TheCl3m/PortableArcade/README.md

### This is the official page of the Portable Arcade project for the course CS-358 @EPFL
