TheCl3m/PortableArcade/docs/assets/gant3d.png

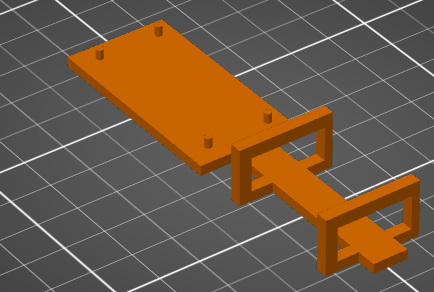
docs/assets/gant3d.png
