TheCl3m/PortableArcade/docs/assets/joy.gif

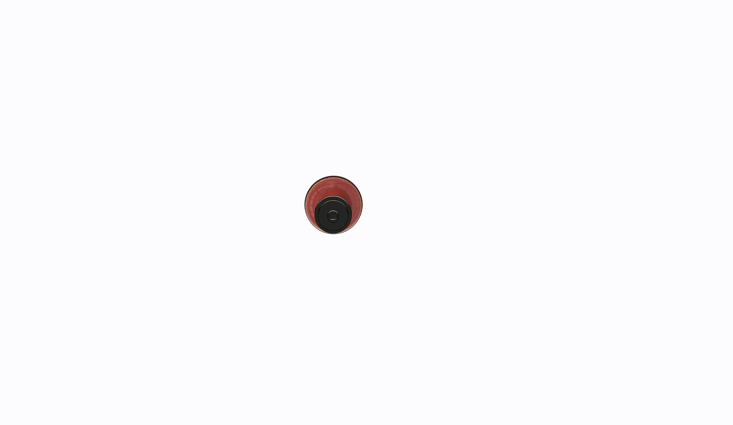
docs/assets/joy.gif
