TheCl3m/PortableArcade/docs/assets/lever.gif

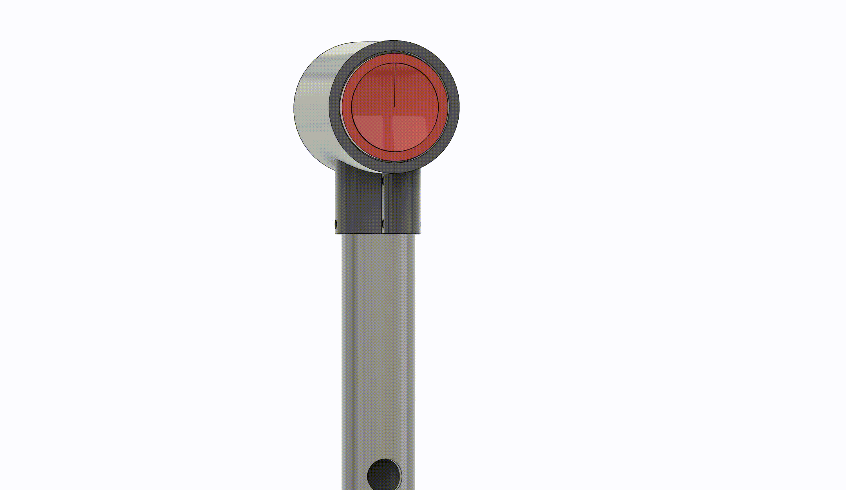
docs/assets/lever.gif
