TheCl3m/PortableArcade/3D-Printing/JoystickAndButtons/Joysticks and Buttons/Joystick head.stl

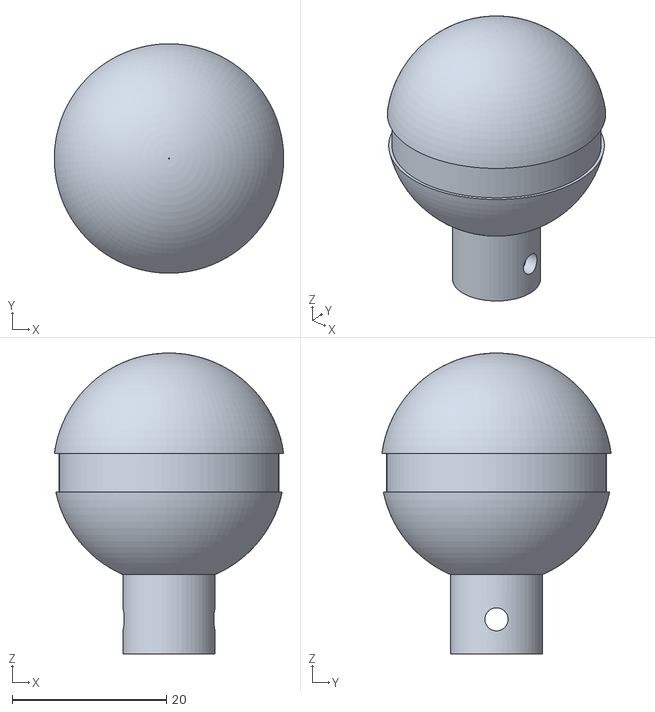
[picture p9: CAD file, 2022-06-02]
3D-Printing/JoystickAndButtons/Joysticks and Buttons/Joystick head.stl
29.8 x 29.8 x 39.1
