TheCl3m/PortableArcade/3D-Printing/SteeringWheel/Steering wheel and gear lever/Gear Lever/Lever head right.stl

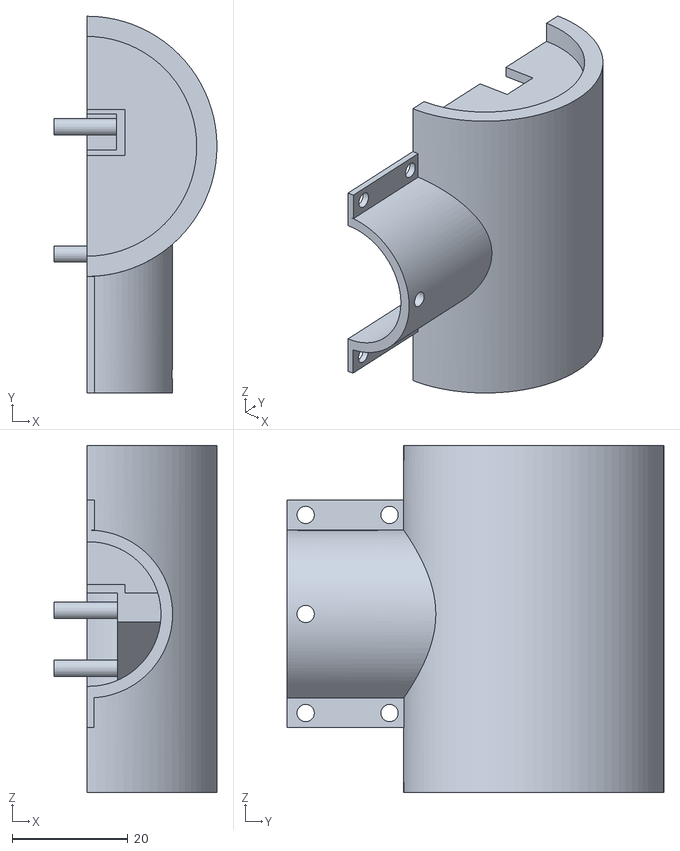
[picture p10: CAD file, 2022-06-02]
3D-Printing/SteeringWheel/Steering wheel and gear lever/Gear Lever/Lever head right.stl
28.2 x 65.1 x 60.0
