TheCl3m/PortableArcade/3D-Printing/SteeringWheel/Steering wheel and gear lever/Wheel/Grip Bottom.stl

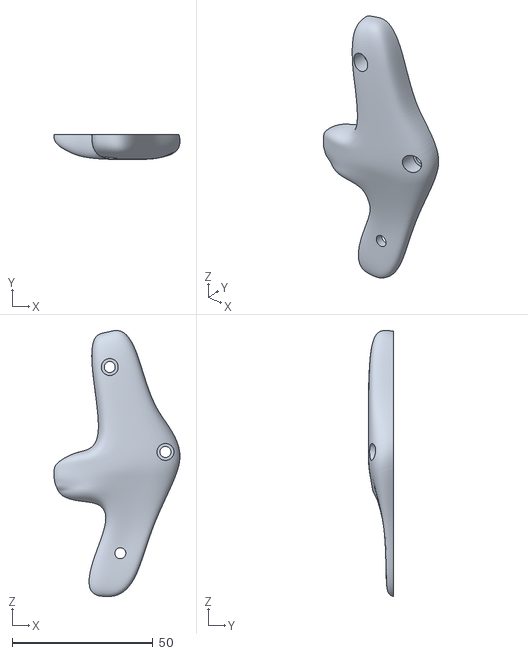
[picture p11: CAD file, 2022-06-02]
3D-Printing/SteeringWheel/Steering wheel and gear lever/Wheel/Grip Bottom.stl
44.8 x 9.02 x 94.5
