TheCl3m/PortableArcade/3D-Printing/JoystickAndButtons/Joysticks and Buttons/Circle base final.stl

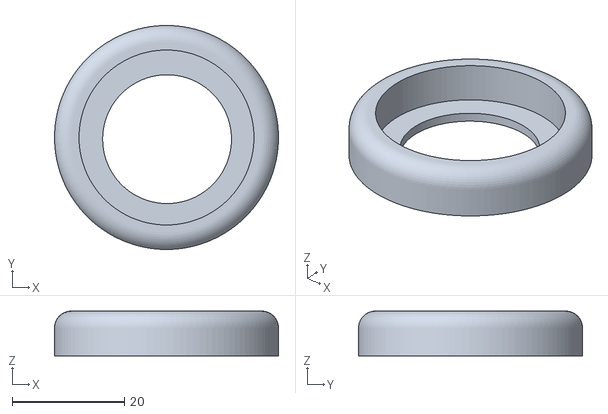
[picture p12: CAD file, 2022-06-02]
3D-Printing/JoystickAndButtons/Joysticks and Buttons/Circle base final.stl
40.0 x 40.0 x 8.00
