TheCl3m/PortableArcade/3D-Printing/SteeringWheel/Steering wheel and gear lever/Gear Lever/Lever.stl

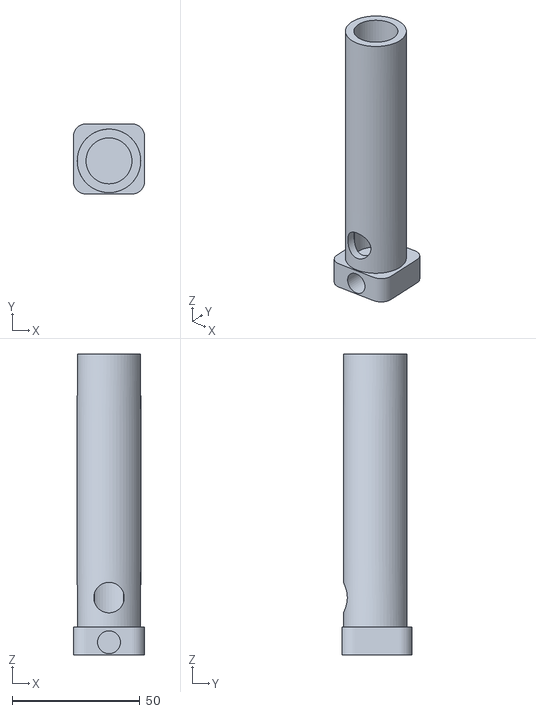
[picture p13: CAD file, 2022-06-02]
3D-Printing/SteeringWheel/Steering wheel and gear lever/Gear Lever/Lever.stl
28.0 x 27.5 x 118.0
