TheCl3m/PortableArcade/3D-Printing/SteeringWheel/Steering wheel and gear lever/Wheel/Potentiometer holder.stl

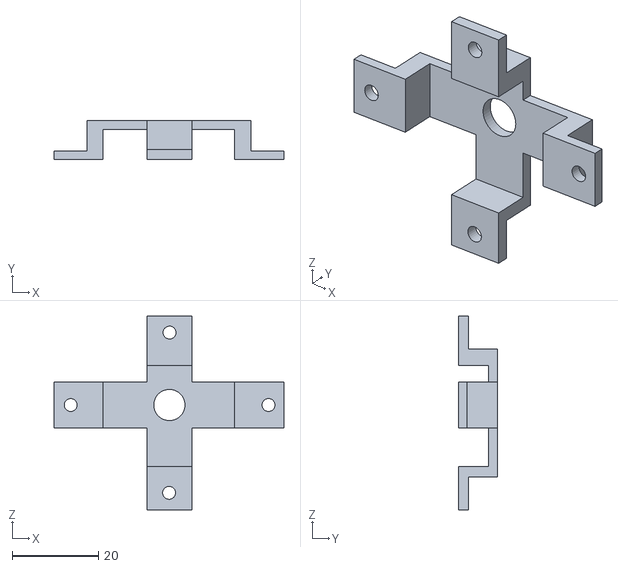
[picture p14: CAD file, 2022-06-02]
3D-Printing/SteeringWheel/Steering wheel and gear lever/Wheel/Potentiometer holder.stl
53.3 x 8.97 x 45.0
