TheCl3m/PortableArcade/3D-Printing/JoystickAndButtons/Joysticks and Buttons/Microswitch module.stl

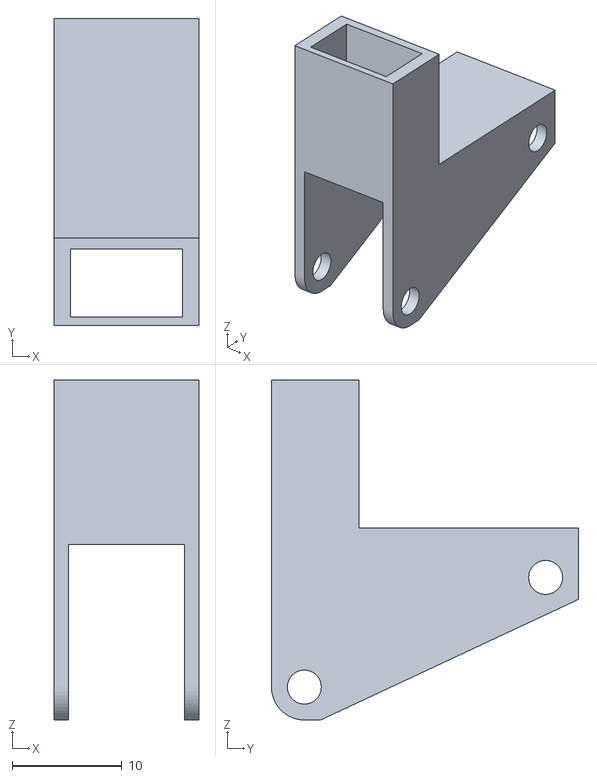
[picture p15: CAD file, 2022-06-02]
3D-Printing/JoystickAndButtons/Joysticks and Buttons/Microswitch module.stl
13.2 x 28.0 x 31.0
