TheCl3m/PortableArcade/3D-Printing/SteeringWheel/Steering wheel and gear lever/Gear Lever/Solid stick.stl

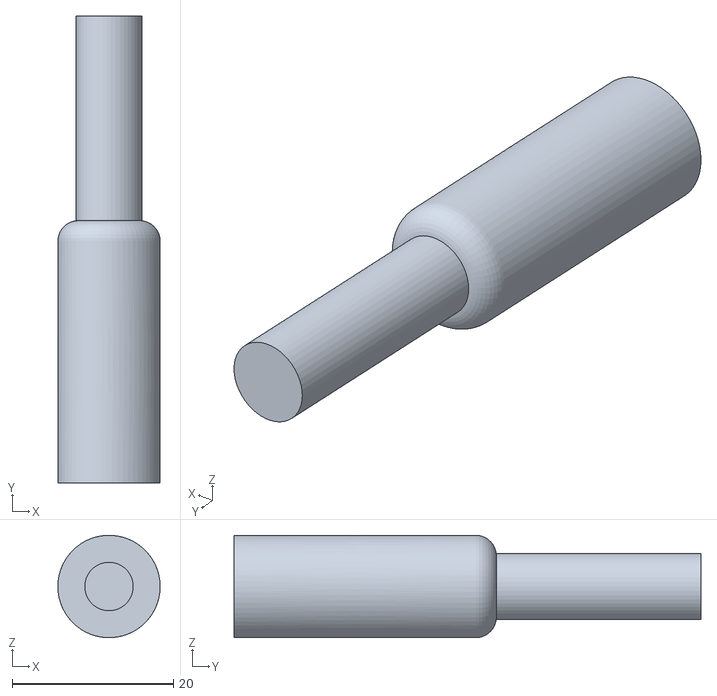
[picture p16: CAD file, 2022-06-02]
3D-Printing/SteeringWheel/Steering wheel and gear lever/Gear Lever/Solid stick.stl
12.7 x 57.9 x 12.7
