TheCl3m/PortableArcade/3D-Printing/SteeringWheel/Steering wheel and gear lever/Wheel/Grip Top.stl

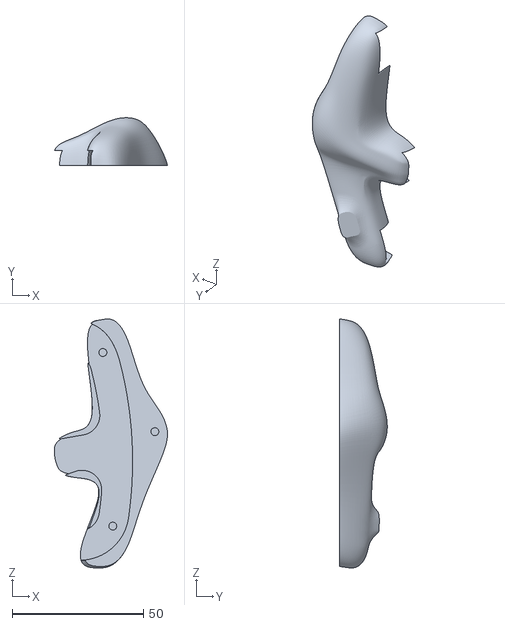
[picture p17: CAD file, 2022-06-02]
3D-Printing/SteeringWheel/Steering wheel and gear lever/Wheel/Grip Top.stl
43.1 x 18.1 x 94.9
