TheCl3m/PortableArcade/3D-Printing/JoystickAndButtons/Joysticks and Buttons/Joystick stick.stl

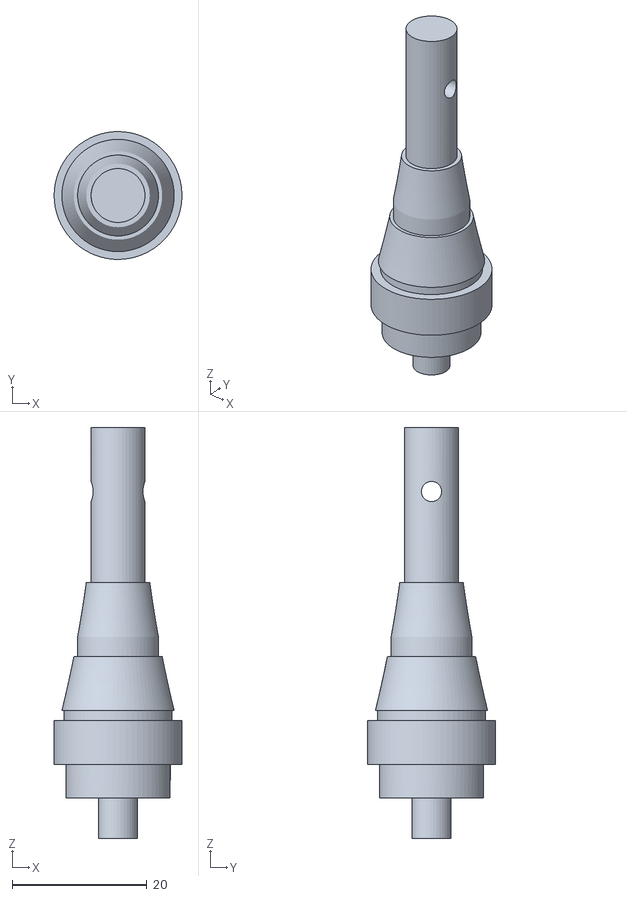
[picture p18: CAD file, 2022-06-02]
3D-Printing/JoystickAndButtons/Joysticks and Buttons/Joystick stick.stl
19.0 x 19.0 x 61.0
