TheCl3m/PortableArcade/3D-Printing/SteeringWheel/Steering wheel and gear lever/Gear Lever/Weights.stl

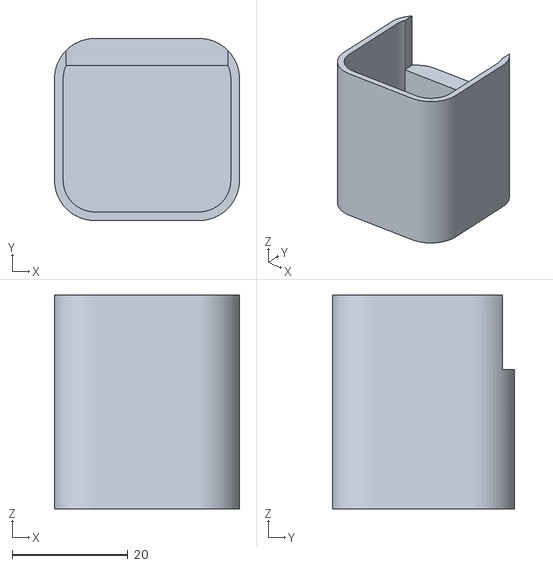
[picture p19: CAD file, 2022-06-02]
3D-Printing/SteeringWheel/Steering wheel and gear lever/Gear Lever/Weights.stl
32.0 x 31.5 x 37.0
