TheCl3m/PortableArcade/3D-Printing/SteeringWheel/Steering wheel and gear lever/Gear Lever/Lever presser.stl

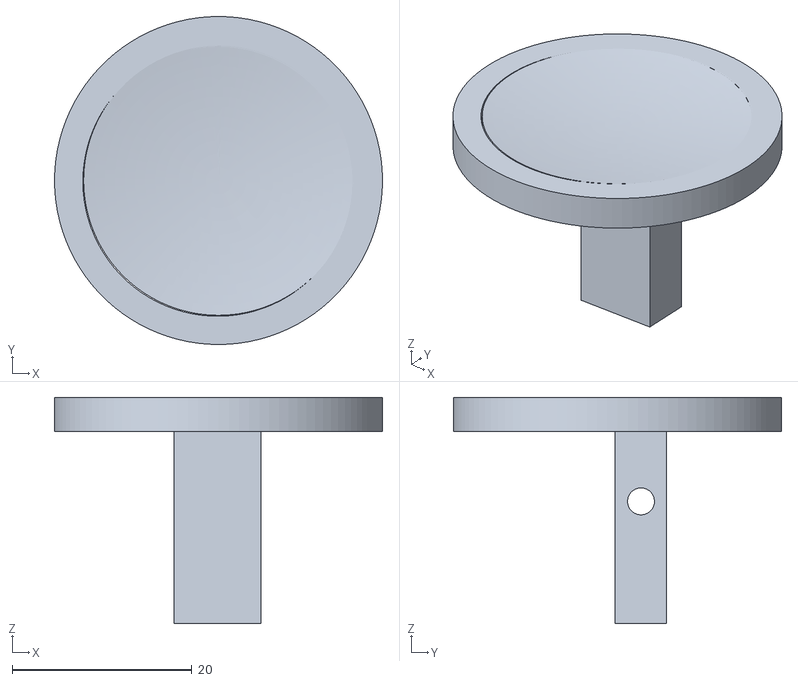
[picture p20: CAD file, 2022-06-02]
3D-Printing/SteeringWheel/Steering wheel and gear lever/Gear Lever/Lever presser.stl
36.5 x 36.5 x 25.2
