TheCl3m/PortableArcade/3D-Printing/SteeringWheel/Steering wheel and gear lever/Wheel/Wooden box module.stl

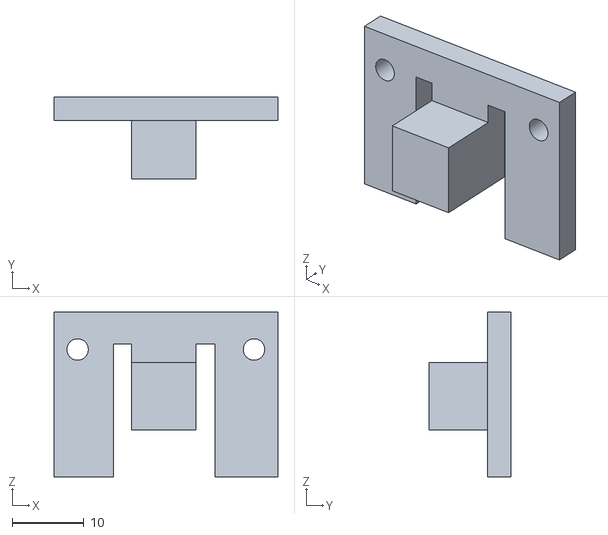
[picture p21: CAD file, 2022-06-02]
3D-Printing/SteeringWheel/Steering wheel and gear lever/Wheel/Wooden box module.stl
31.3 x 11.4 x 23.0
