TheCl3m/PortableArcade/3D-Printing/JoystickAndButtons/Joysticks and Buttons/Box top.stl

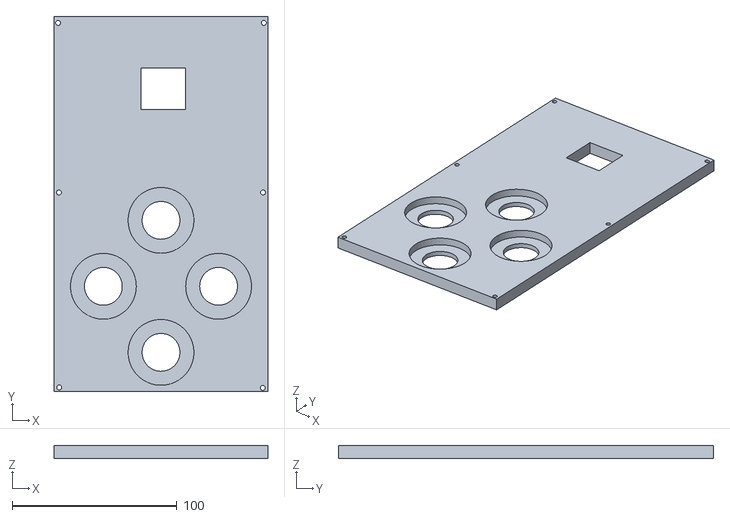
[picture p22: CAD file, 2022-06-02]
3D-Printing/JoystickAndButtons/Joysticks and Buttons/Box top.stl
130.0 x 228.0 x 8.00
