TheCl3m/PortableArcade/3D-Printing/SteeringWheel/Steering wheel and gear lever/Wheel/Wheel box.stl

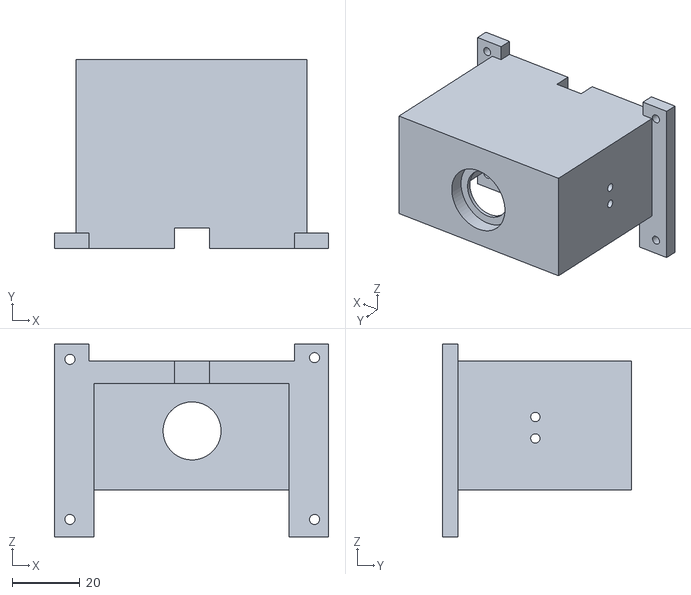
[picture p24: CAD file, 2022-06-02]
3D-Printing/SteeringWheel/Steering wheel and gear lever/Wheel/Wheel box.stl
81.2 x 55.9 x 57.1
