TheCl3m/PortableArcade/3D-Printing/JoystickAndButtons/Joysticks and Buttons/Box Bottom.stl

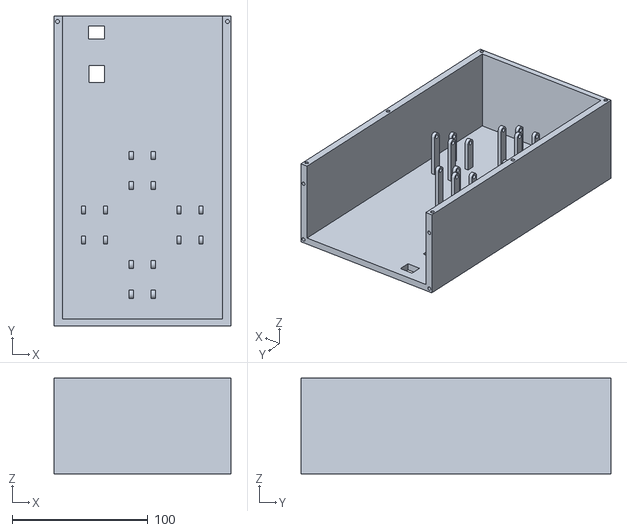
[picture p25: CAD file, 2022-06-02]
3D-Printing/JoystickAndButtons/Joysticks and Buttons/Box Bottom.stl
130.0 x 228.0 x 70.5
