TheCl3m/PortableArcade/3D-Printing/SteeringWheel/Steering wheel and gear lever/Wheel/Steering Shaft.stl

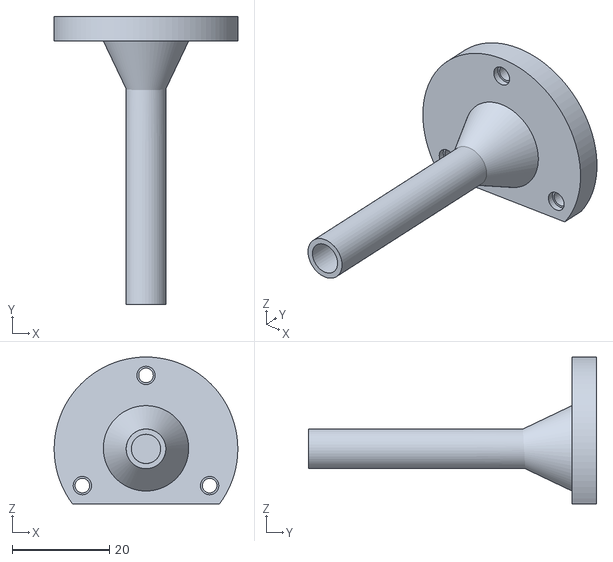
[picture p30: CAD file, 2022-06-02]
3D-Printing/SteeringWheel/Steering wheel and gear lever/Wheel/Steering Shaft.stl
37.7 x 59.1 x 30.2
