TheCl3m/PortableArcade/(list of files, cad)

Other CAD files:
3D-Printing/SteeringWheel/Steering wheel and gear lever/Wheel/Grip Bottom(Mirror).stl
3D-Printing/SteeringWheel/Steering wheel and gear lever/Wheel/Grip Top(Mirror).stl
3D-Printing/JoystickAndButtons/Joysticks and Buttons/Presser with screw Hole.stl
