TheCl3m/PortableArcade/(commit log)

2022-04-26 nouveau code arduino
2022-04-29 fixed arduino
2022-04-30 sans fonction de setup
2022-05-17 added 3D and laser directories
2022-05-19 added heart button support to script and comments
2022-05-24 Update index.md
    laser cutter
2022-05-30 Added raspberry pi imager gif
2022-06-02 added circuit images and fixed main
    [JoystickController.ino, main.py]
2022-06-02 changed steering wheel dir name
2022-06-02 3D printing files added
    [Box Bottom.stl, Box top.stl, Circle base final.stl, Grip Bottom(Mirror).stl, Grip Bottom.stl, Grip Top(Mirror).stl, Grip Top.stl, Joystick head.stl]
2022-06-05 renamed steering wheel controller
